acidbourbon/remote_stereo/README.md

This is the repository containing the source files for the remote controlled stereo amplifier with four-channel line mixer.
Details here:

https://acidbourbon.wordpress.com/2014/02/18/remotehifi/

2013 by Michael Wiebusch
mwiebusch.de
