acidbourbon/remote_stereo/pcb/bestueckungsplan.pdf

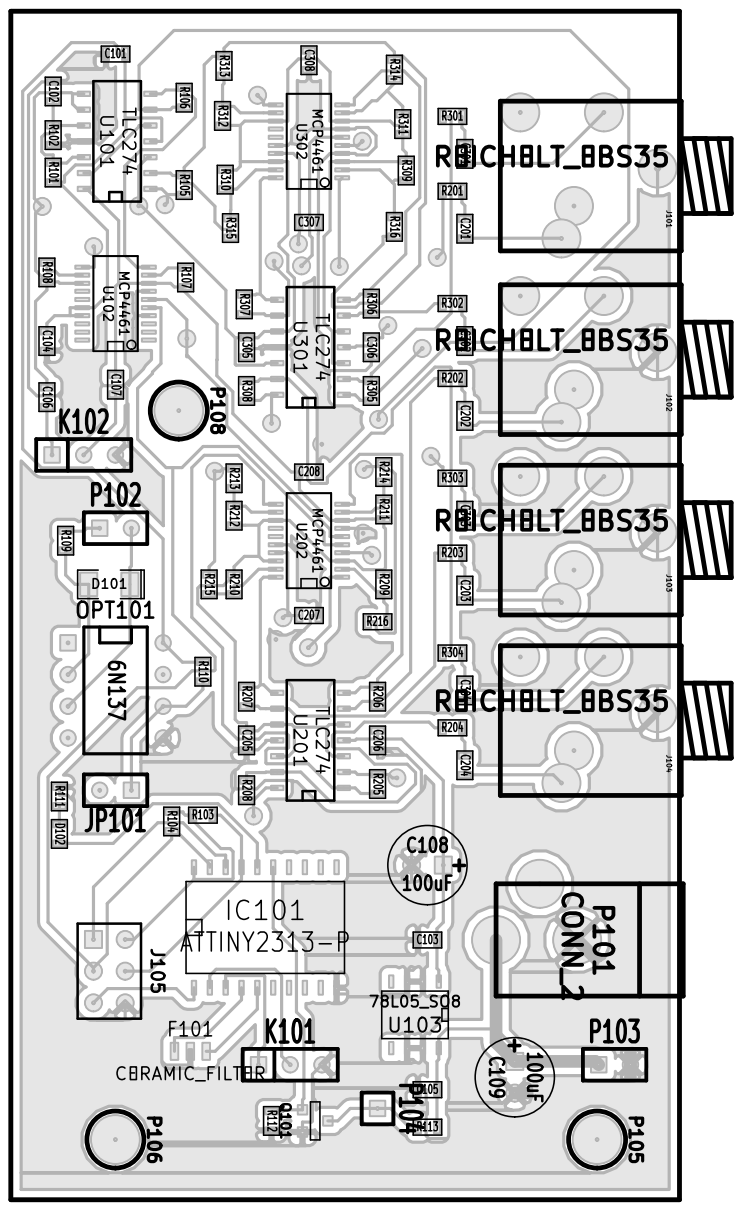
[picture p1: page 1]
