acidbourbon/remote_stereo/pcb/usbamp-Back.pdf

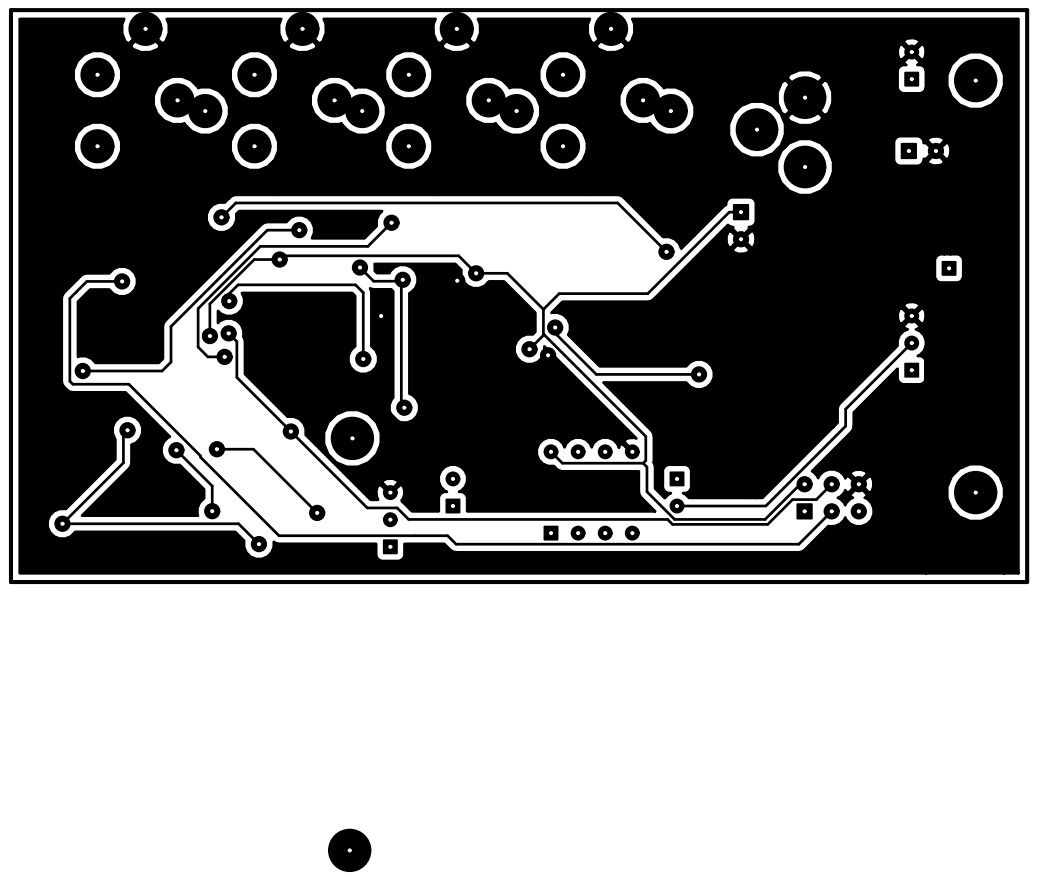
[picture p2: page 1]
