acidbourbon/remote_stereo/pcb/usbamp-Front.pdf

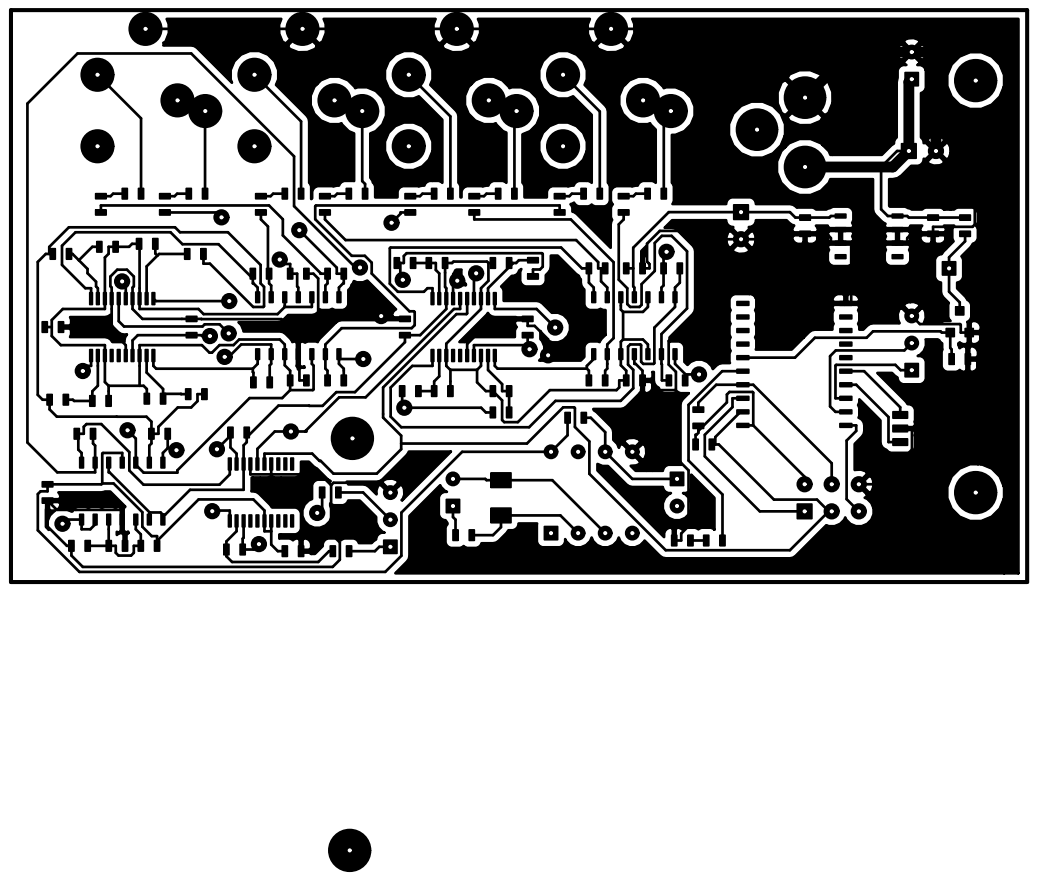
[picture p3: page 1]
