acidbourbon/remote_stereo/pcb/usbamp-Mixer_L.sch.pdf

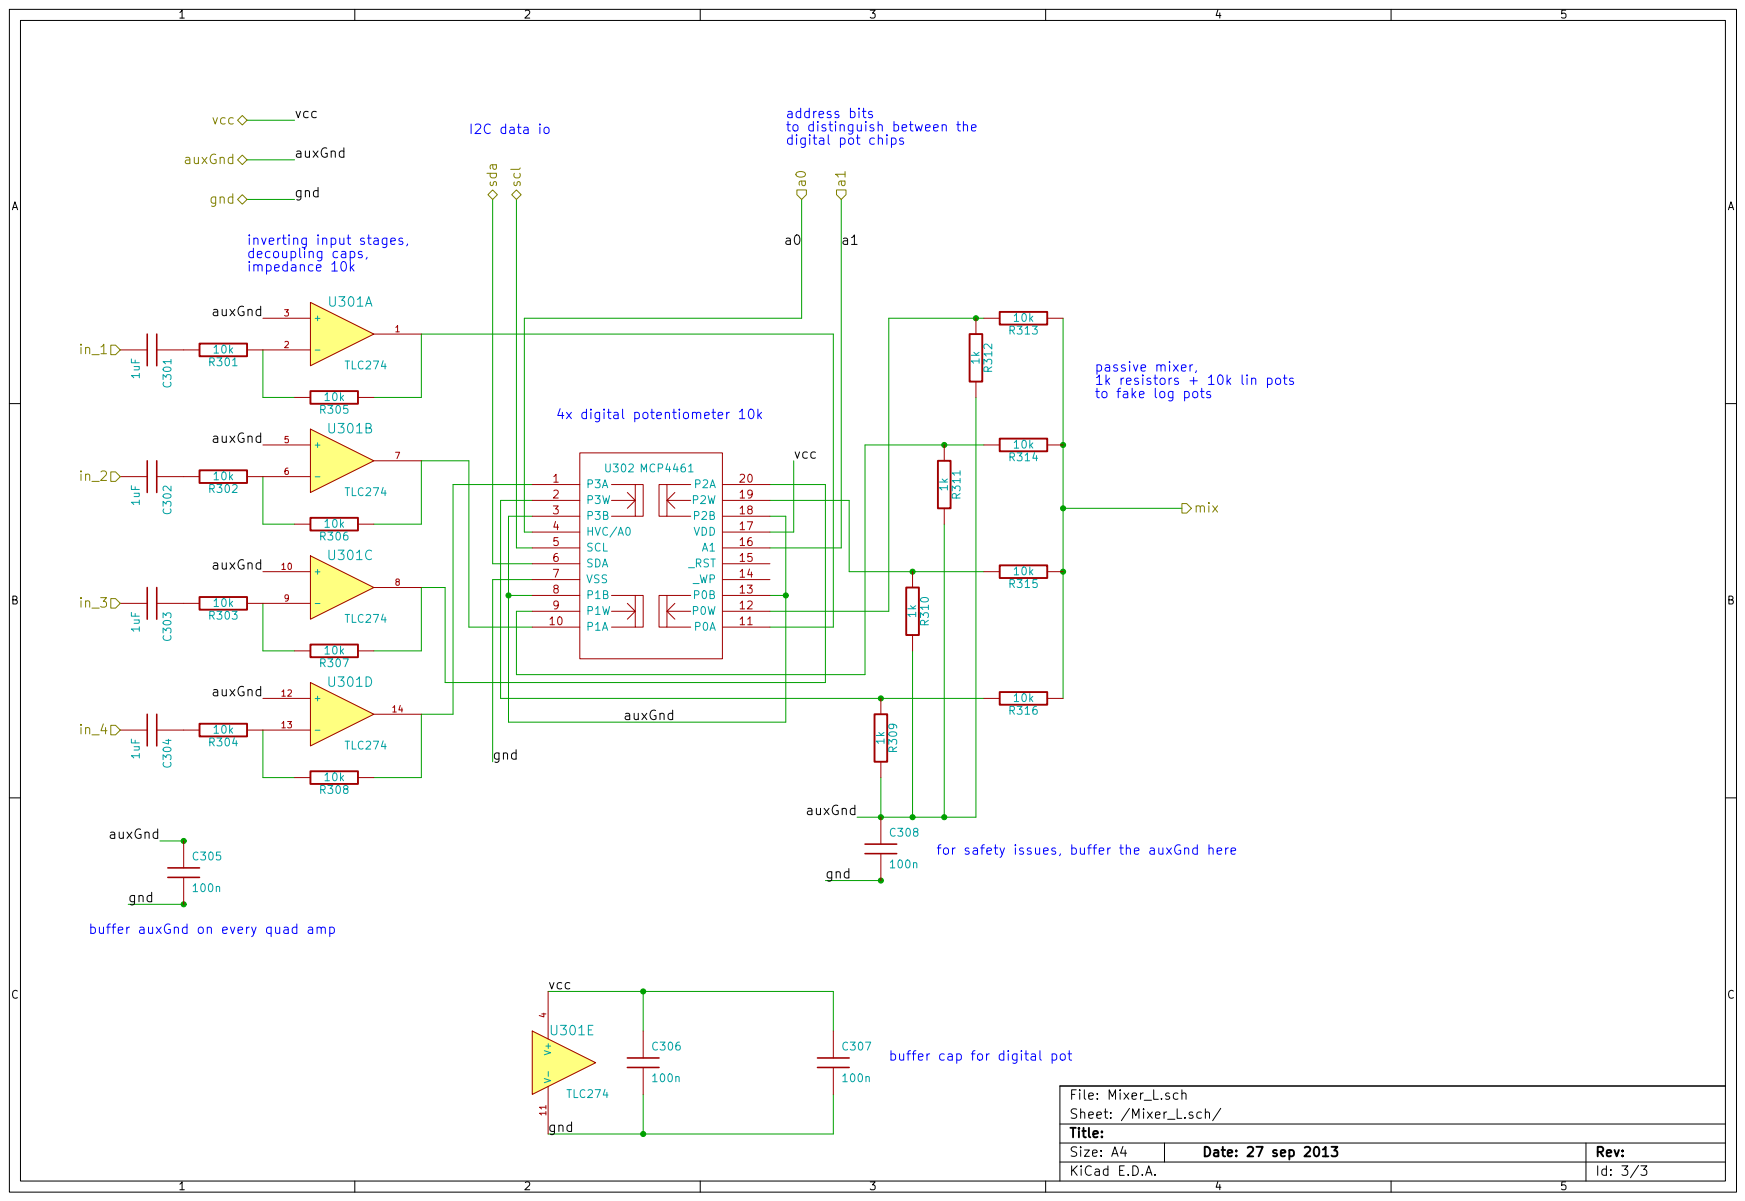
[picture p4: page 1]
