acidbourbon/remote_stereo/pcb/usbamp-Mixer_R.sch.pdf

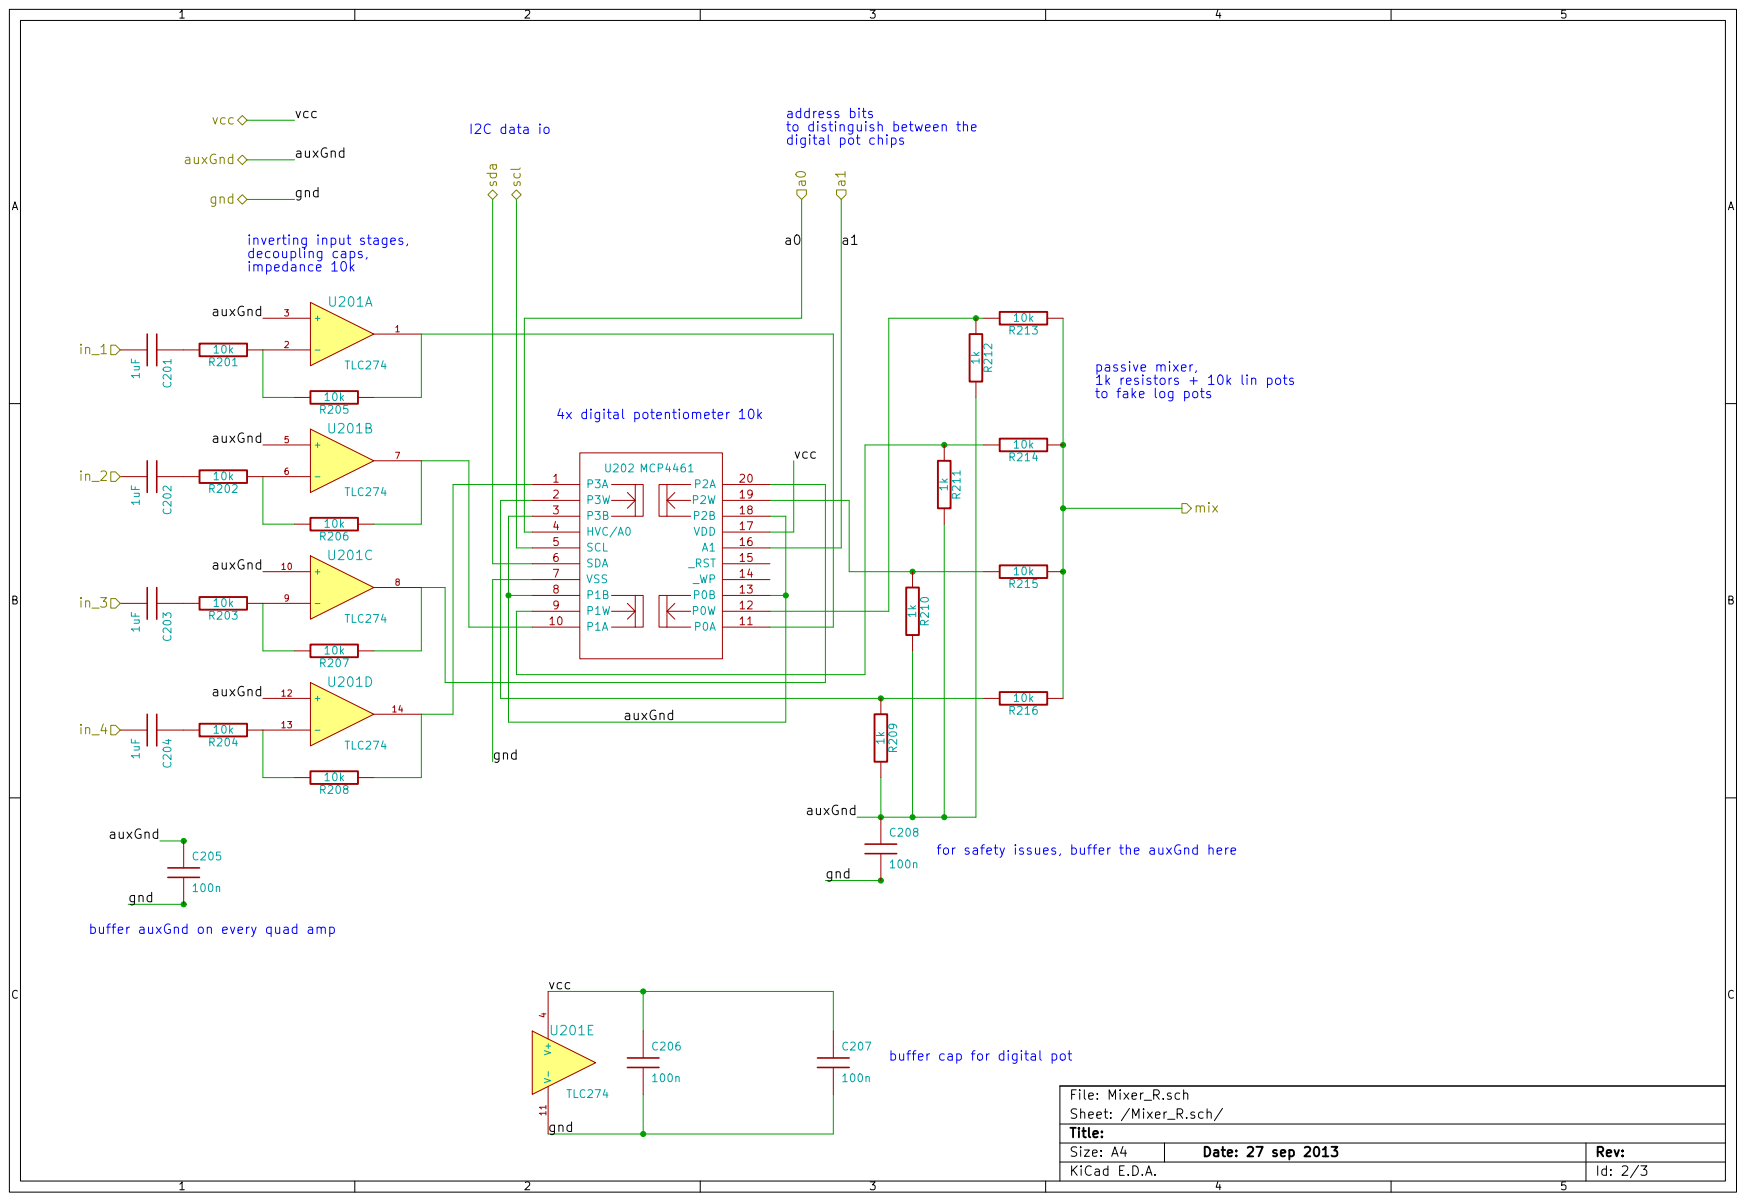
[picture p5: page 1]
