acidbourbon/remote_stereo/pcb/usbamp-SilkS_Front.pdf

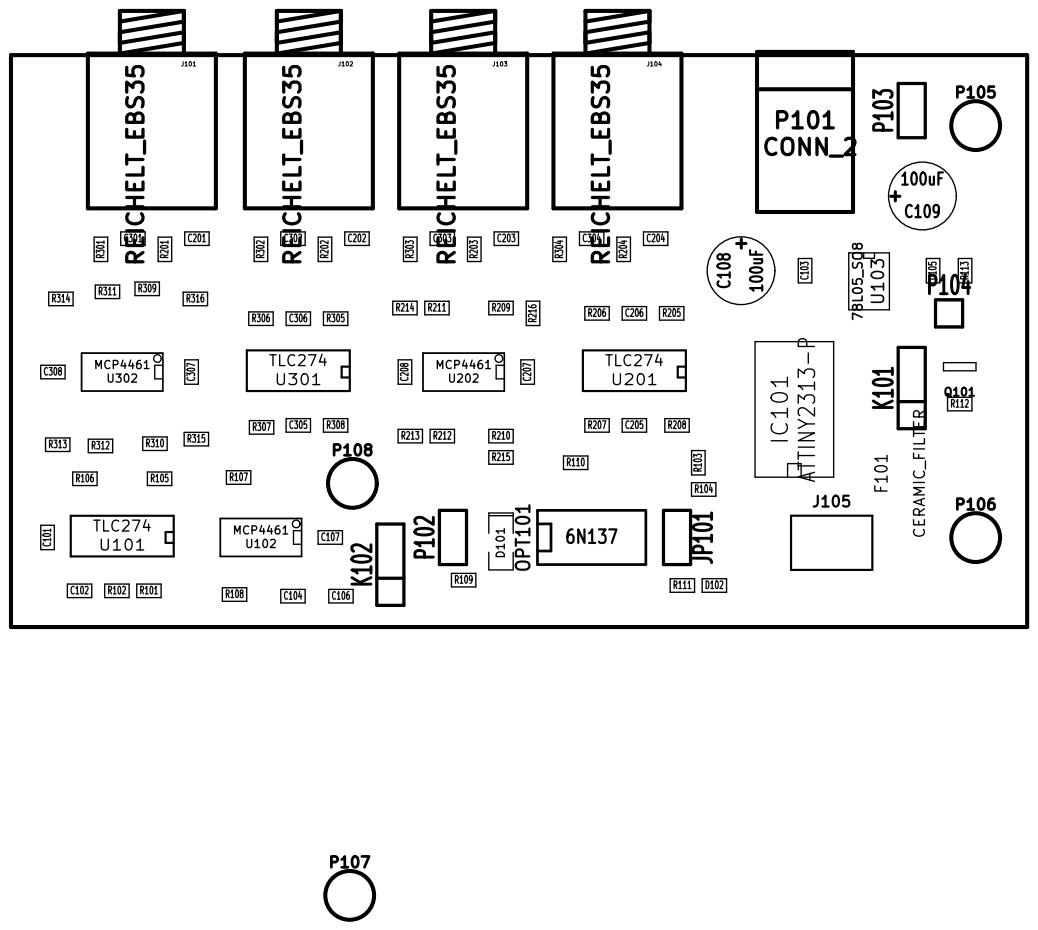
[picture p6: page 1]
