acidbourbon/remote_stereo/pcb/usbamp.pdf

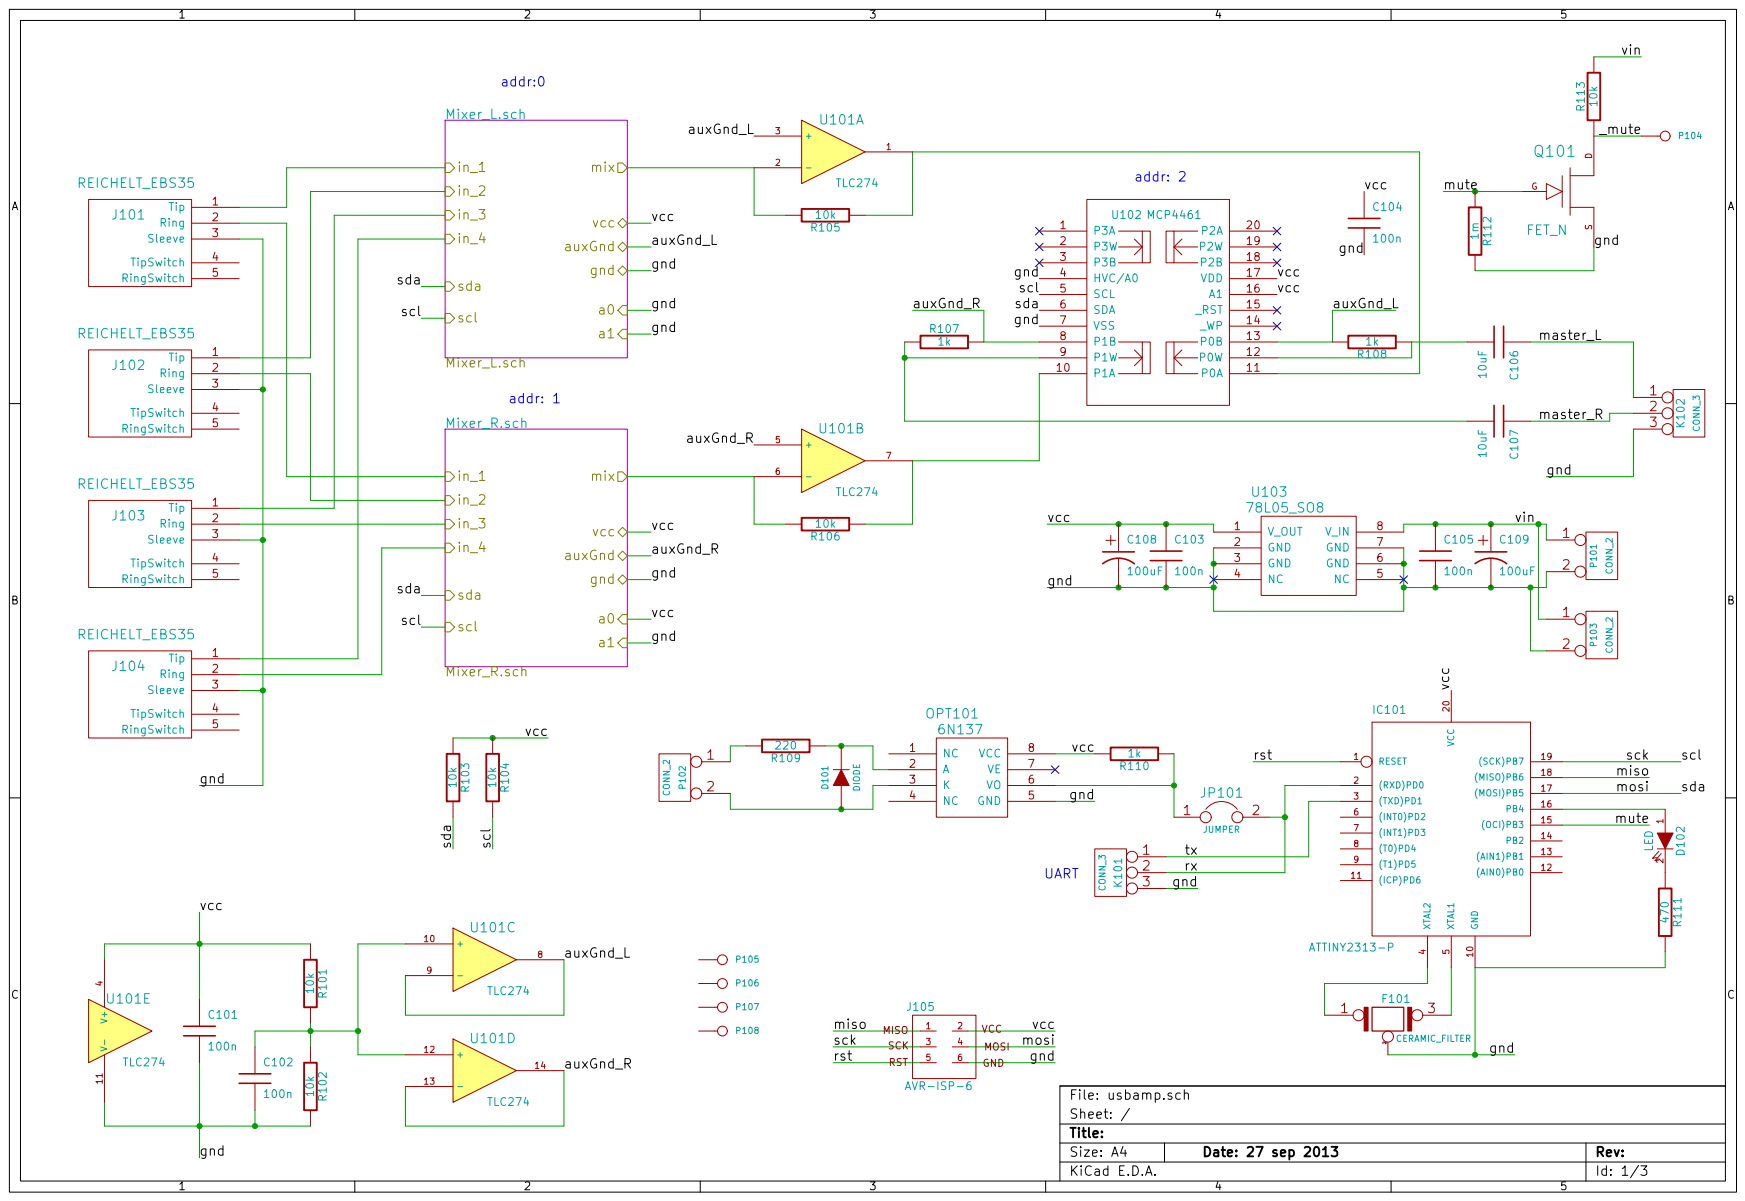
[picture p7: page 1]
