acidbourbon/remote_stereo/(list of files, drawings)

Other design files:
pcb/usbamp.dsn
