acidbourbon/remote_stereo/pcb/Mixer_L.sch

## KiCad design pcb/Mixer_L.sch (2016-03-09)

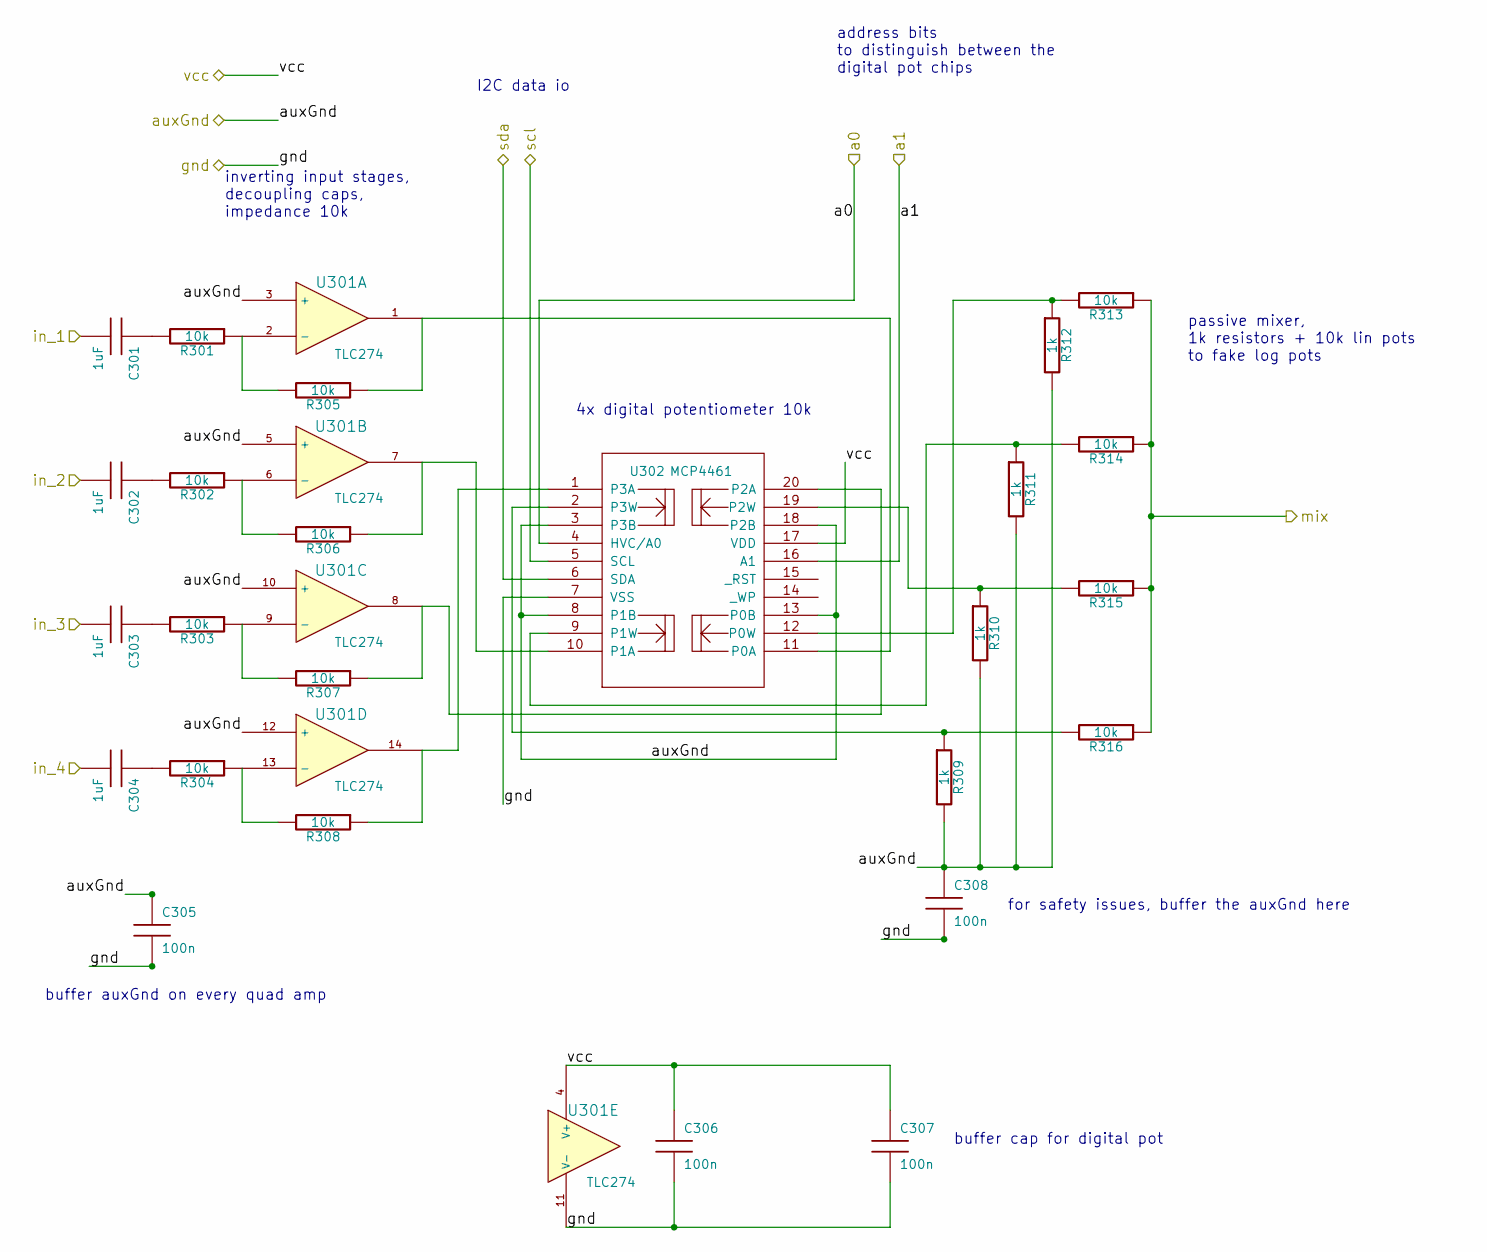
[picture p8: schematic Mixer_L.sch]

Parts:
C301, C302, C303, C304: 1uF
C305, C306, C307, C308: 100n
R301, R302, R303, R304, R305, R306, R307, R308, R313, R314, R315, R316: 10k
R309, R310, R311, R312: 1k
U301: TLC274
U302: MCP4461; I2C

Connections:
unnamed: C301.1, R301.2
unnamed: C302.1, R302.2
unnamed: C303.1, R303.2
unnamed: C304.1, R304.2
unnamed: R301.1, R305.2, U301.2 (-)
unnamed: R302.1, R306.2, U301.6 (-)
unnamed: R303.1, R307.2, U301.9 (-)
unnamed: R304.1, R308.2, U301.13 (-)
unnamed: R305.1, U301.1, U302.11 (P0A)
unnamed: R306.1, U301.7, U302.10 (P1A)
unnamed: R307.1, U301.8, U302.20 (P2A)
unnamed: R308.1, U301.14, U302.1 (P3A)
unnamed: R309.1, R316.2, U302.2 (P3W)
unnamed: R310.1, R315.2, U302.19 (P2W)
unnamed: R311.1, R314.2, U302.9 (P1W)
unnamed: R312.1, R313.2, U302.12 (P0W)
a0: U302.4 (HVC/A0)
a1: U302.16 (A1)
auxGnd: C305.1, C308.1, R309.2, R310.2, R311.2, R312.2, U301.3 (+), U301.5 (+), U301.10 (+), U301.12 (+), U302.3 (P3B), U302.8 (P1B), U302.13 (P0B), U302.18 (P2B)
gnd: C305.2, C306.2, C307.2, C308.2, U301.11 (V-), U302.7 (VSS)
in_1: C301.2
in_2: C302.2
in_3: C303.2
in_4: C304.2
mix: R313.1, R314.1, R315.1, R316.1
scl: U302.5 (SCL)
sda: U302.6 (SDA)
vcc: C306.1, C307.1, U301.4 (V+), U302.17 (VDD)

Notes on the sheet:
buffer auxGnd on every quad amp
for safety issues, buffer the auxGnd here
buffer cap for digital pot
I2C data io
address bits to distinguish between the digital pot chips
passive mixer, 1k resistors + 10k lin pots to fake log pots
inverting input stages, decoupling caps, impedance 10k
4x digital potentiometer 10k
