acidbourbon/remote_stereo/pcb/Mixer_R.sch

## KiCad design pcb/Mixer_R.sch (2016-03-09)

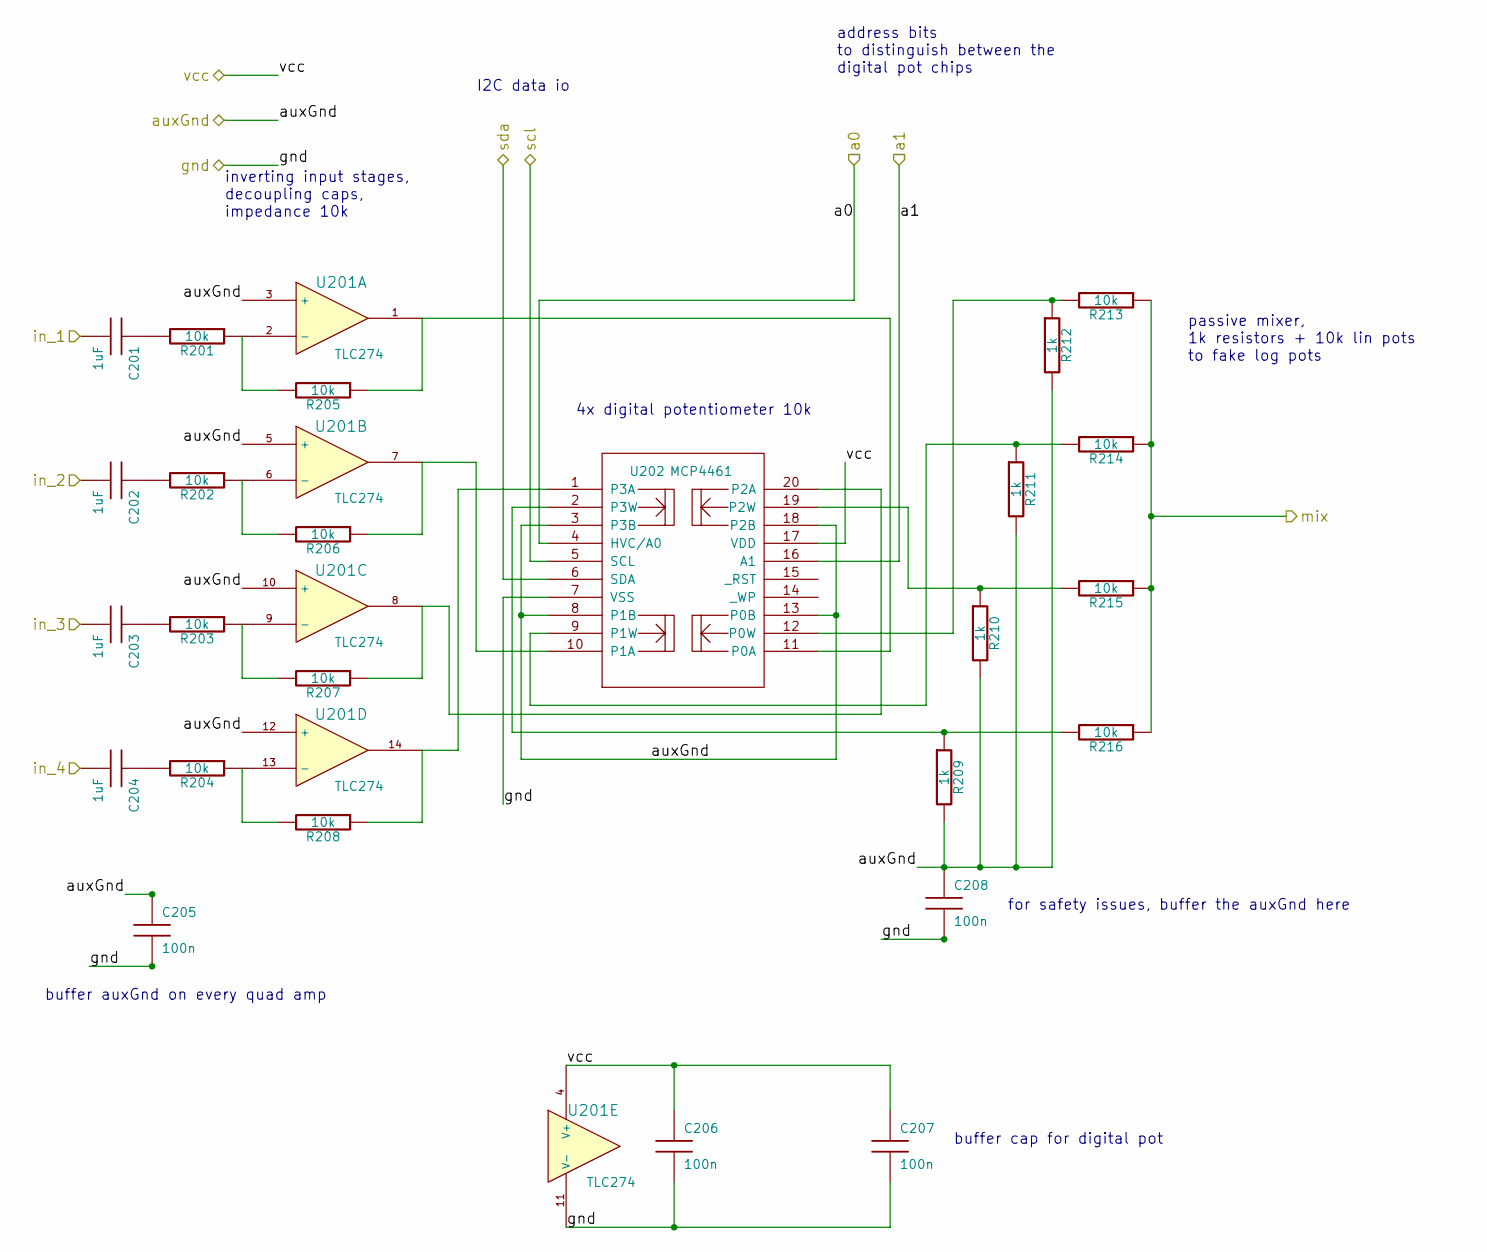
[picture p9: schematic Mixer_R.sch]

Parts:
C201, C202, C203, C204: 1uF
C205, C206, C207, C208: 100n
R201, R202, R203, R204, R205, R206, R207, R208, R213, R214, R215, R216: 10k
R209, R210, R211, R212: 1k
U201: TLC274
U202: MCP4461; I2C

Connections:
unnamed: C201.1, R201.2
unnamed: C202.1, R202.2
unnamed: C203.1, R203.2
unnamed: C204.1, R204.2
unnamed: R201.1, R205.2, U201.2 (-)
unnamed: R202.1, R206.2, U201.6 (-)
unnamed: R203.1, R207.2, U201.9 (-)
unnamed: R204.1, R208.2, U201.13 (-)
unnamed: R205.1, U201.1, U202.11 (P0A)
unnamed: R206.1, U201.7, U202.10 (P1A)
unnamed: R207.1, U201.8, U202.20 (P2A)
unnamed: R208.1, U201.14, U202.1 (P3A)
unnamed: R209.1, R216.2, U202.2 (P3W)
unnamed: R210.1, R215.2, U202.19 (P2W)
unnamed: R211.1, R214.2, U202.9 (P1W)
unnamed: R212.1, R213.2, U202.12 (P0W)
a0: U202.4 (HVC/A0)
a1: U202.16 (A1)
auxGnd: C205.1, C208.1, R209.2, R210.2, R211.2, R212.2, U201.3 (+), U201.5 (+), U201.10 (+), U201.12 (+), U202.3 (P3B), U202.8 (P1B), U202.13 (P0B), U202.18 (P2B)
gnd: C205.2, C206.2, C207.2, C208.2, U201.11 (V-), U202.7 (VSS)
in_1: C201.2
in_2: C202.2
in_3: C203.2
in_4: C204.2
mix: R213.1, R214.1, R215.1, R216.1
scl: U202.5 (SCL)
sda: U202.6 (SDA)
vcc: C206.1, C207.1, U201.4 (V+), U202.17 (VDD)

Notes on the sheet:
buffer auxGnd on every quad amp
for safety issues, buffer the auxGnd here
buffer cap for digital pot
I2C data io
address bits to distinguish between the digital pot chips
passive mixer, 1k resistors + 10k lin pots to fake log pots
inverting input stages, decoupling caps, impedance 10k
4x digital potentiometer 10k
