acidbourbon/remote_stereo/pcb/usbamp.sch

## KiCad design pcb/usbamp.sch (2016-03-09)

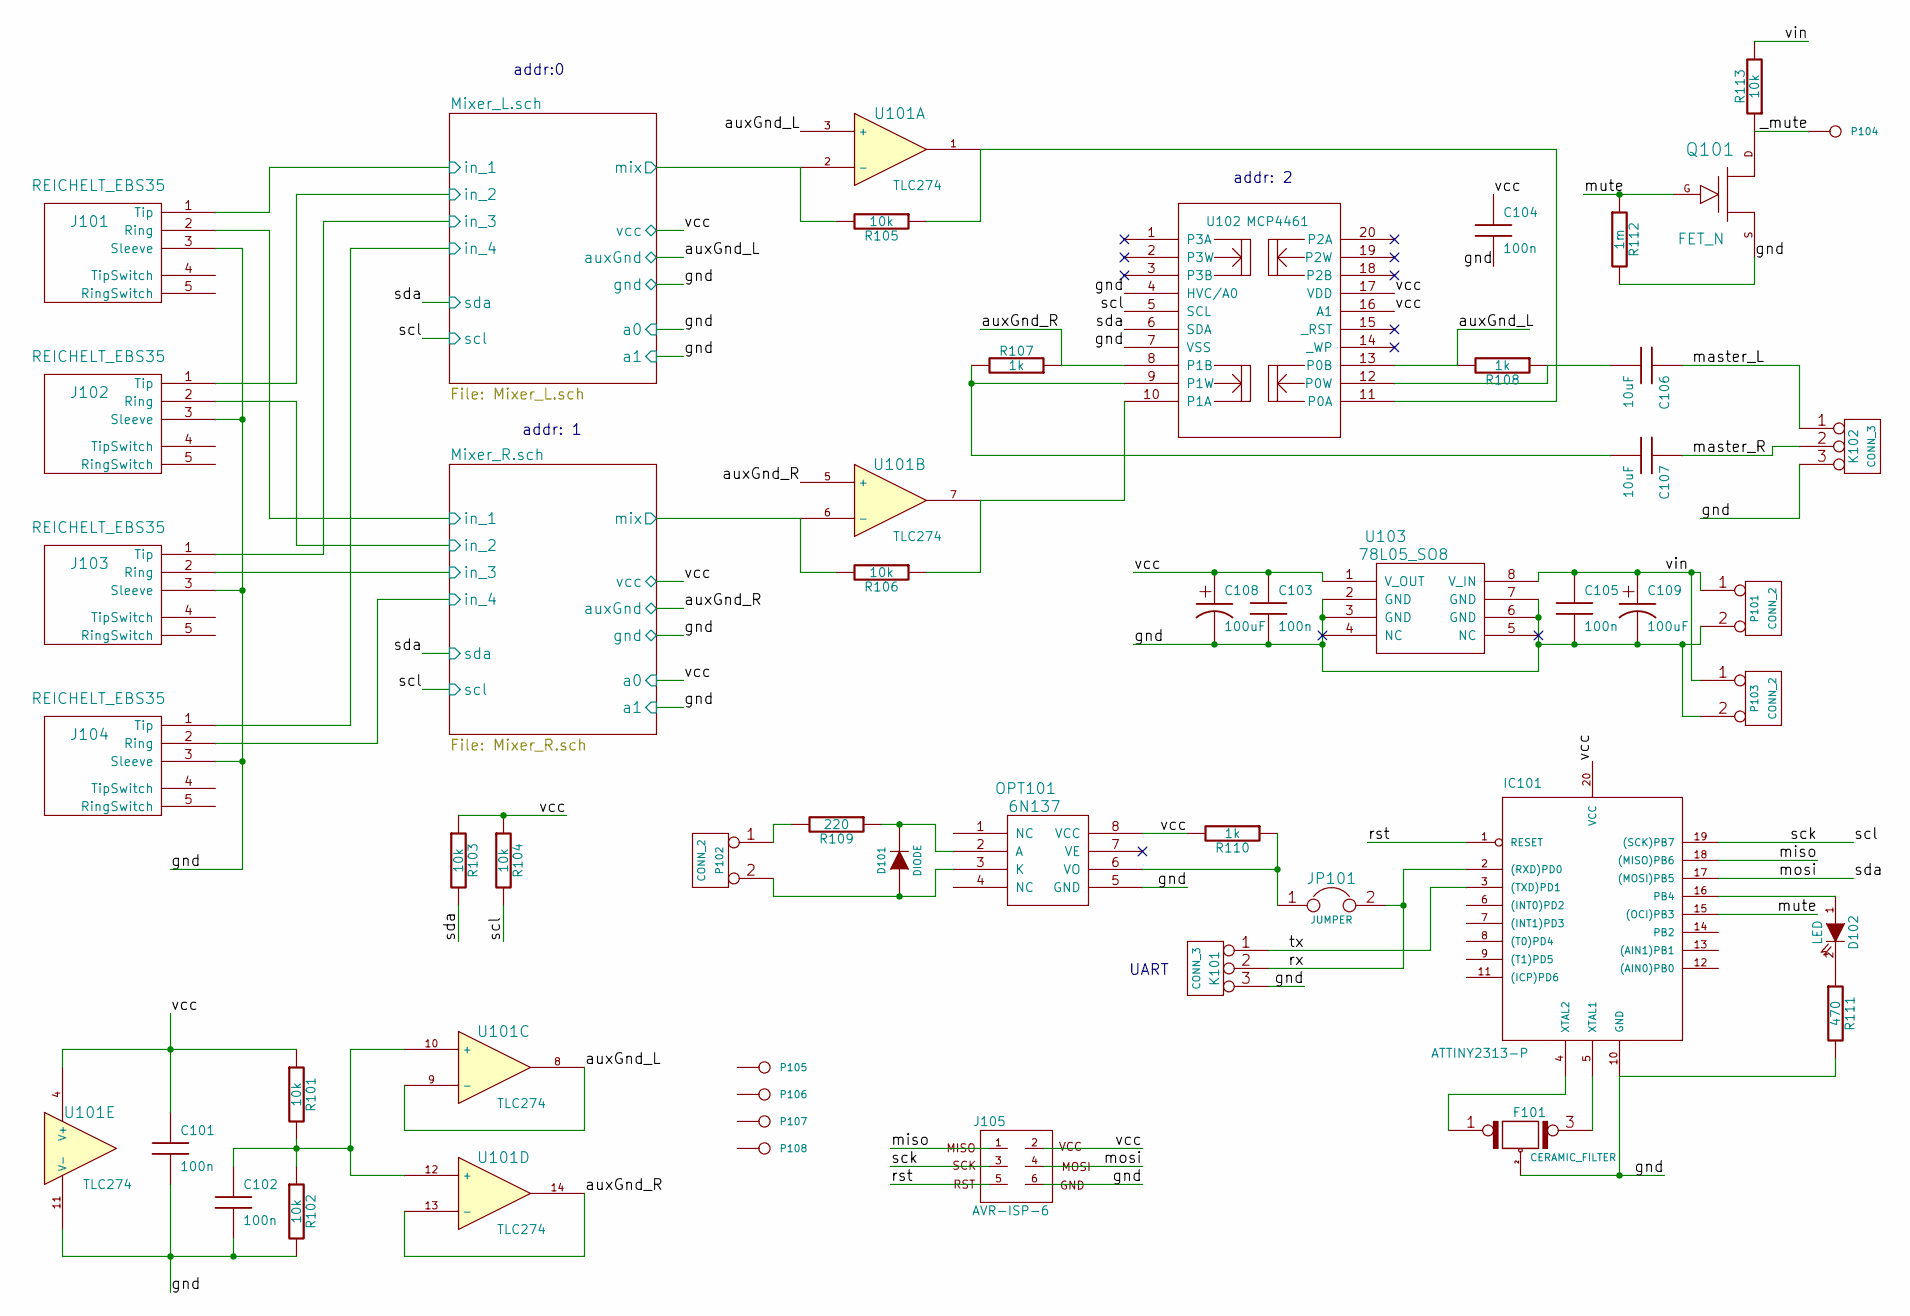
[picture p10: schematic usbamp.sch]

Parts:
C101, C102, C103, C104, C105: 100n
C106, C107: 10uF
C108, C109: 100uF
D101: DIODE
D102: LED
F101: CERAMIC_FILTER
IC101: ATTINY2313-P; DIL20
J101, J102, J103, J104: REICHELT_EBS35
J105: AVR-ISP-6
JP101: JUMPER
K101, K102: CONN_3
OPT101: 6N137
P101, P102, P103: CONN_2
P104, P105, P106, P107, P108: CONN_1
Q101: FET_N
R101, R102, R103, R104, R105, R106, R113: 10k
R107, R108, R110: 1k
R109: 220
R111: 470
R112: 1m
U101: TLC274
U102: MCP4461; I2C
U103: 78L05_SO8

Connections:
unnamed: C102.1, R101.2, R102.1, U101.10 (+), U101.12 (+)
unnamed: C106.2, R108.1, U102.12 (P0W)
unnamed: C107.2, R107.2, U102.9 (P1W)
unnamed: D101.1 (A), OPT101.3 (K), P102.2 (PM)
unnamed: D101.2 (K), OPT101.2 (A), R109.1
unnamed: D102.1 (A), IC101.16 (PB4)
unnamed: D102.2 (K), R111.1
unnamed: F101.1, IC101.4 (XTAL2)
unnamed: F101.3, IC101.5 (XTAL1)
unnamed: JP101.1, OPT101.6 (VO), R110.1
unnamed: P102.1, R109.2
unnamed: R105.1, U101.1, U102.11 (P0A)
unnamed: R106.1, U101.7, U102.10 (P1A)
_mute: P104.1, Q101.D, R113.1
auxGnd_L: R108.2, U101.3 (+), U101.8, U101.9 (-), U102.13 (P0B)
auxGnd_R: R107.1, U101.5 (+), U101.13 (-), U101.14, U102.8 (P1B)
gnd: C101.2, C102.2, C103.2, C104.2, C105.2, C108.2, C109.2, F101.2 (PM), IC101.10 (GND), J101.3 (Sleeve), J102.3 (Sleeve), J103.3 (Sleeve), J104.3 (Sleeve), J105.6, K101.3, K102.3, OPT101.5 (GND), P101.2 (PM), P103.2 (PM), Q101.S, R102.2, R111.2, R112.2, U101.11 (V-), U102.4 (HVC/A0), U102.7 (VSS), U103.2 (GND), U103.3 (GND), U103.6 (GND), U103.7 (GND)
in_1: J101.1 (Tip), J101.2 (Ring)
in_2: J102.1 (Tip), J102.2 (Ring)
in_3: J103.1 (Tip), J103.2 (Ring)
in_4: J104.1 (Tip), J104.2 (Ring)
master_L: C106.1, K102.1
master_R: C107.1, K102.2 (PM)
miso: IC101.18 ((MISO)PB6), J105.1
mix: R105.2, R106.2, U101.2 (-), U101.6 (-)
mosi: IC101.17 ((MOSI)PB5), J105.4, R103.2, U102.6 (SDA)
mute: IC101.15 ((OCI)PB3), Q101.G, R112.1
rst: IC101.1 (RESET), J105.5
rx: IC101.2 ((RXD)PD0), JP101.2, K101.2 (PM)
sck: IC101.19 ((SCK)PB7), J105.3, R104.2, U102.5 (SCL)
tx: IC101.3 ((TXD)PD1), K101.1
vcc: C101.1, C103.1, C104.1, C108.1, IC101.20 (VCC), J105.2, OPT101.8 (VCC), R101.1, R103.1, R104.1, R110.2, U101.4 (V+), U102.16 (A1), U102.17 (VDD), U103.1 (V_OUT)
vin: C105.1, C109.1, P101.1, P103.1, R113.2, U103.8 (V_IN)

Notes on the sheet:
UART
addr: 2
addr: 1
addr:0
