acidbourbon/remote_stereo/(commit log)

2013-07-17 fleury uart not working ... meh
    [main.c]
2013-07-17 jey, endlich geht der scheiß mit minimal uart
2014-01-28 the version that was on the device ... working
2016-03-09 added PCB project data
    [$savepcb.brd, Mixer_L.sch, Mixer_R.sch, usbamp.brd, usbamp.dsn, usbamp.sch]
